RBSC/YIS805_VideoBoard/Pics/tested.jpg

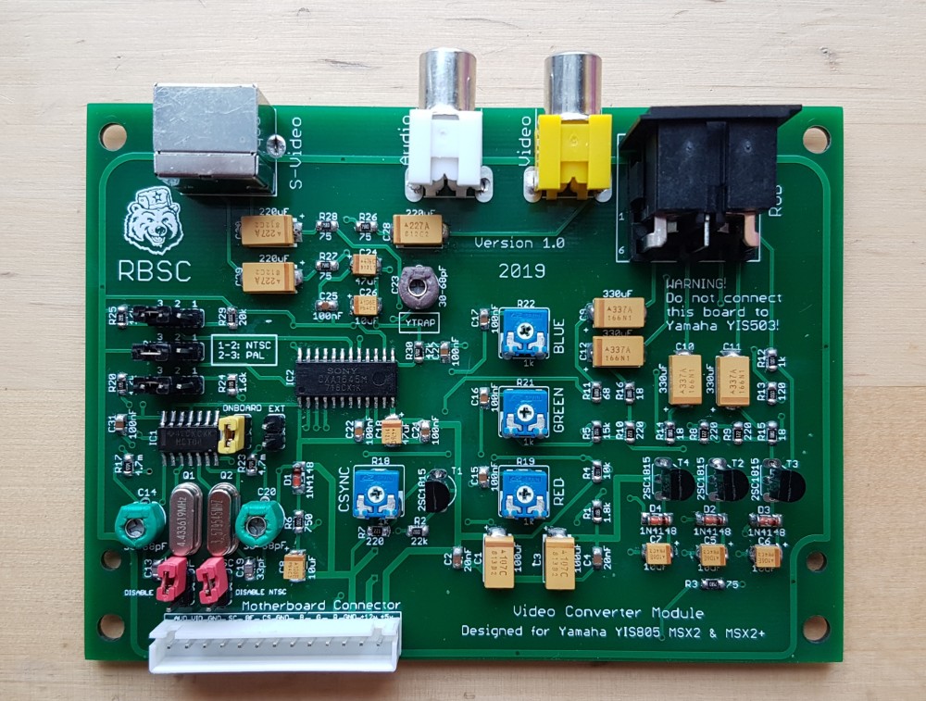
Pics/tested.jpg
