RBSC/YIS805_VideoBoard/Pics/videoboardback.jpg

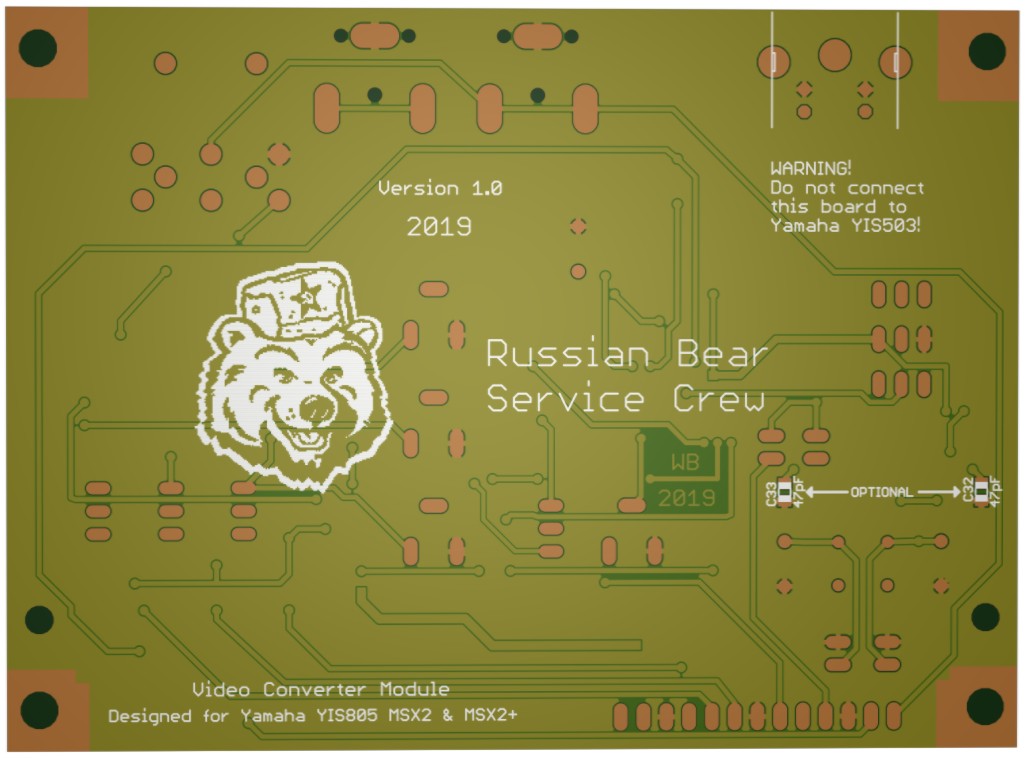
Pics/videoboardback.jpg
