RBSC/YIS805_VideoBoard/Doc/schematics.png

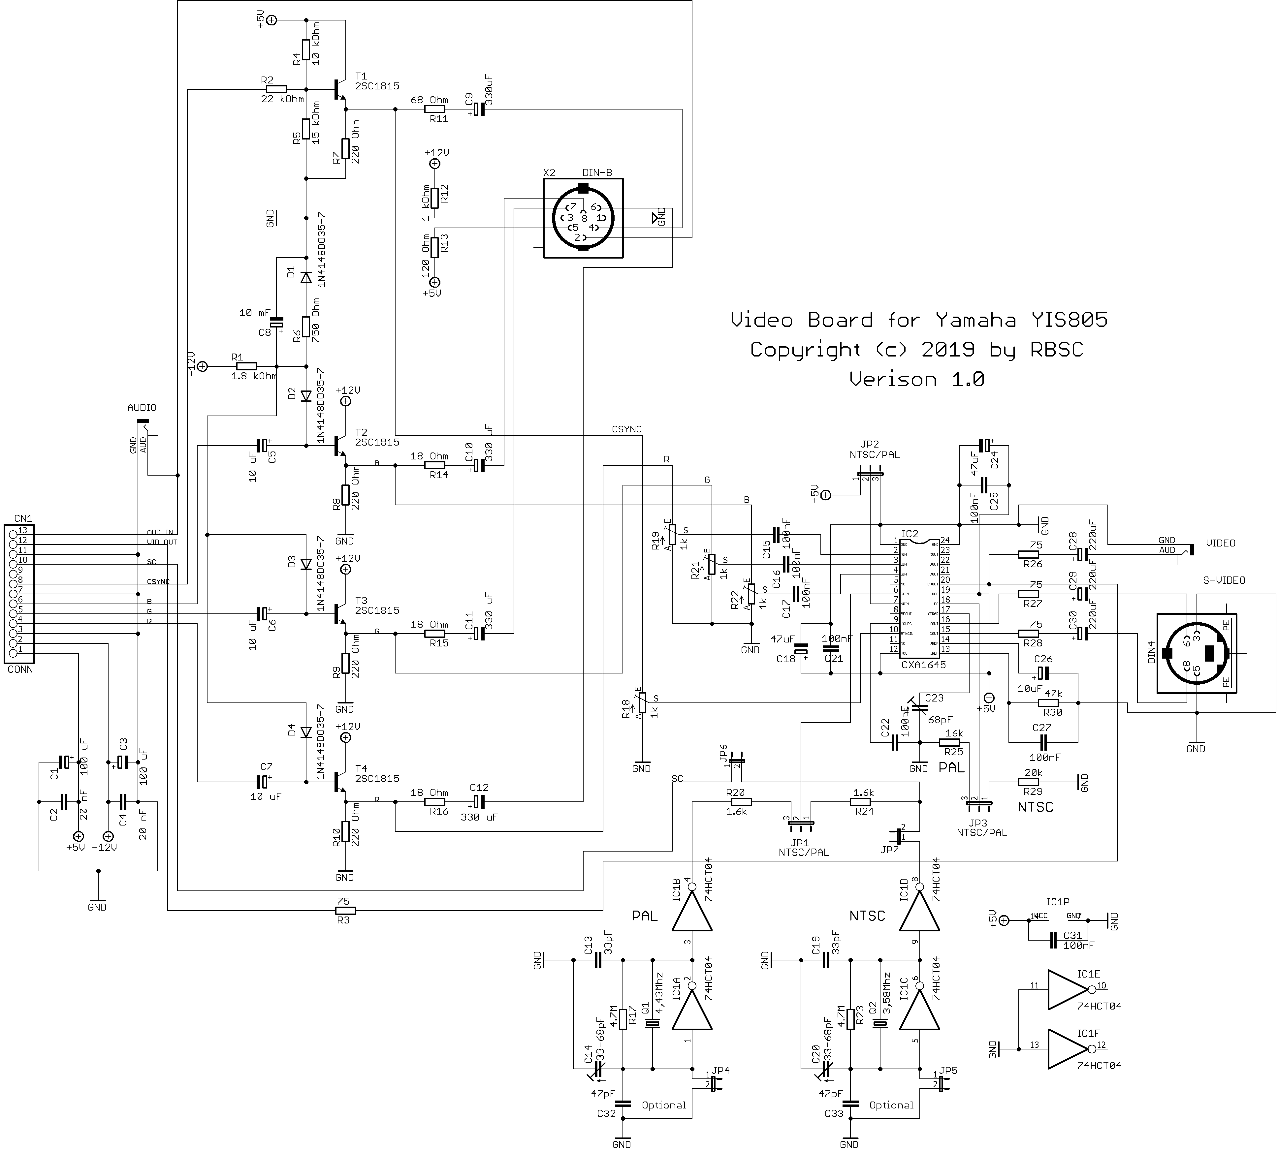
Doc/schematics.png
