RBSC/YIS805_VideoBoard/Pics/videoboard.jpg

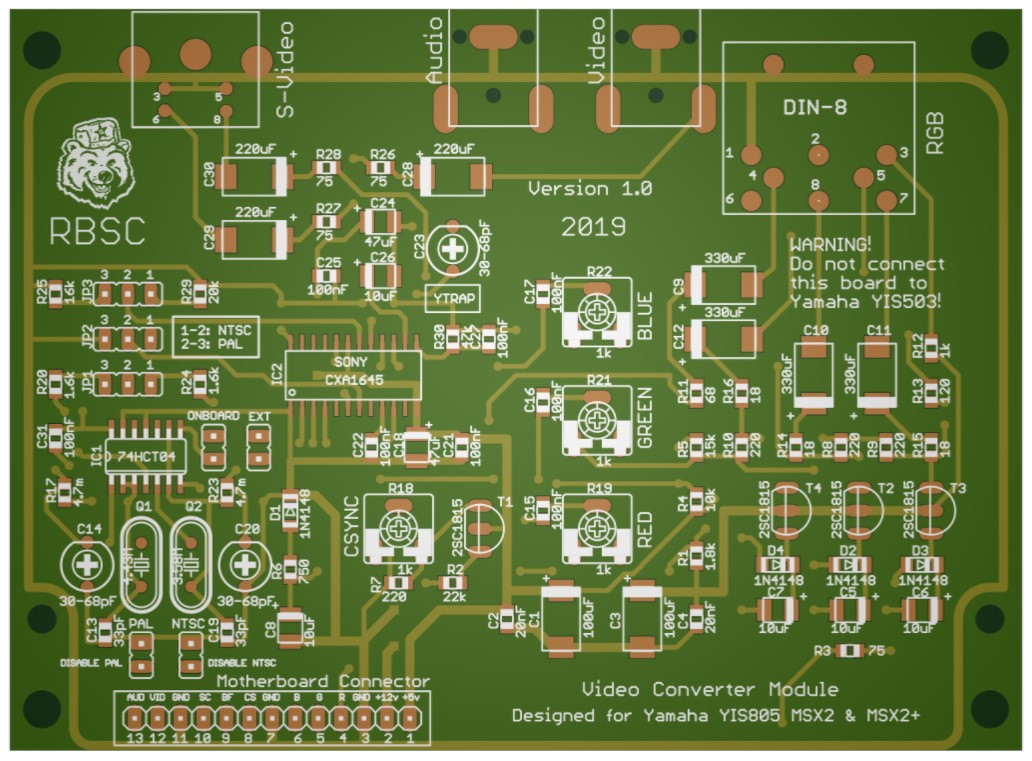
Pics/videoboard.jpg
