RBSC/YIS805_VideoBoard/Pics/videoboard_final.jpg

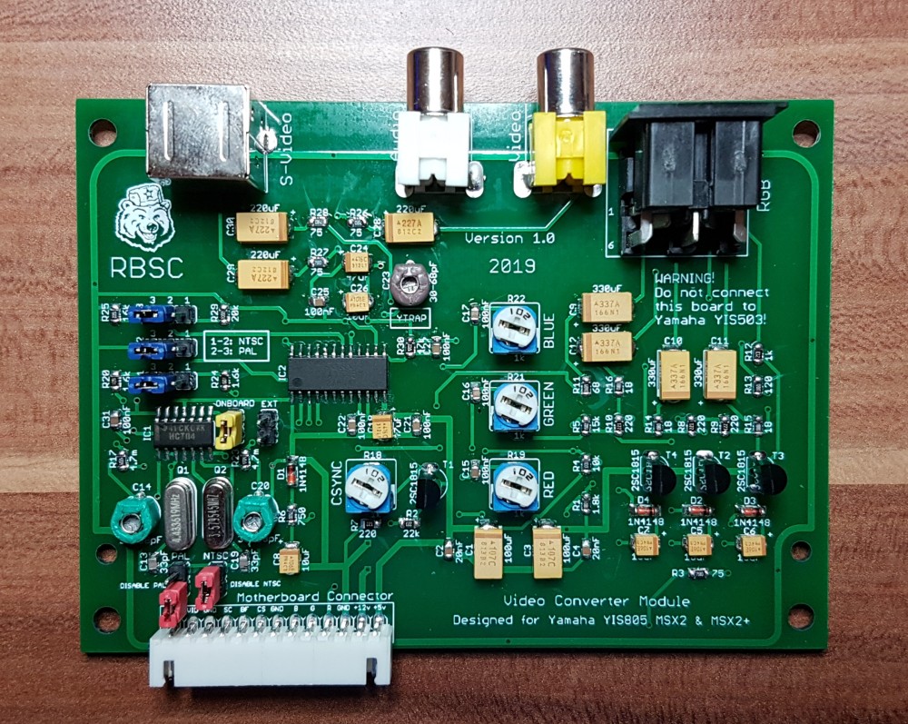
Pics/videoboard_final.jpg
