RBSC/YIS805_VideoBoard/Board/video_board_yis805.brd

## EAGLE design Board/video_board_yis805.brd (2019-12-11)

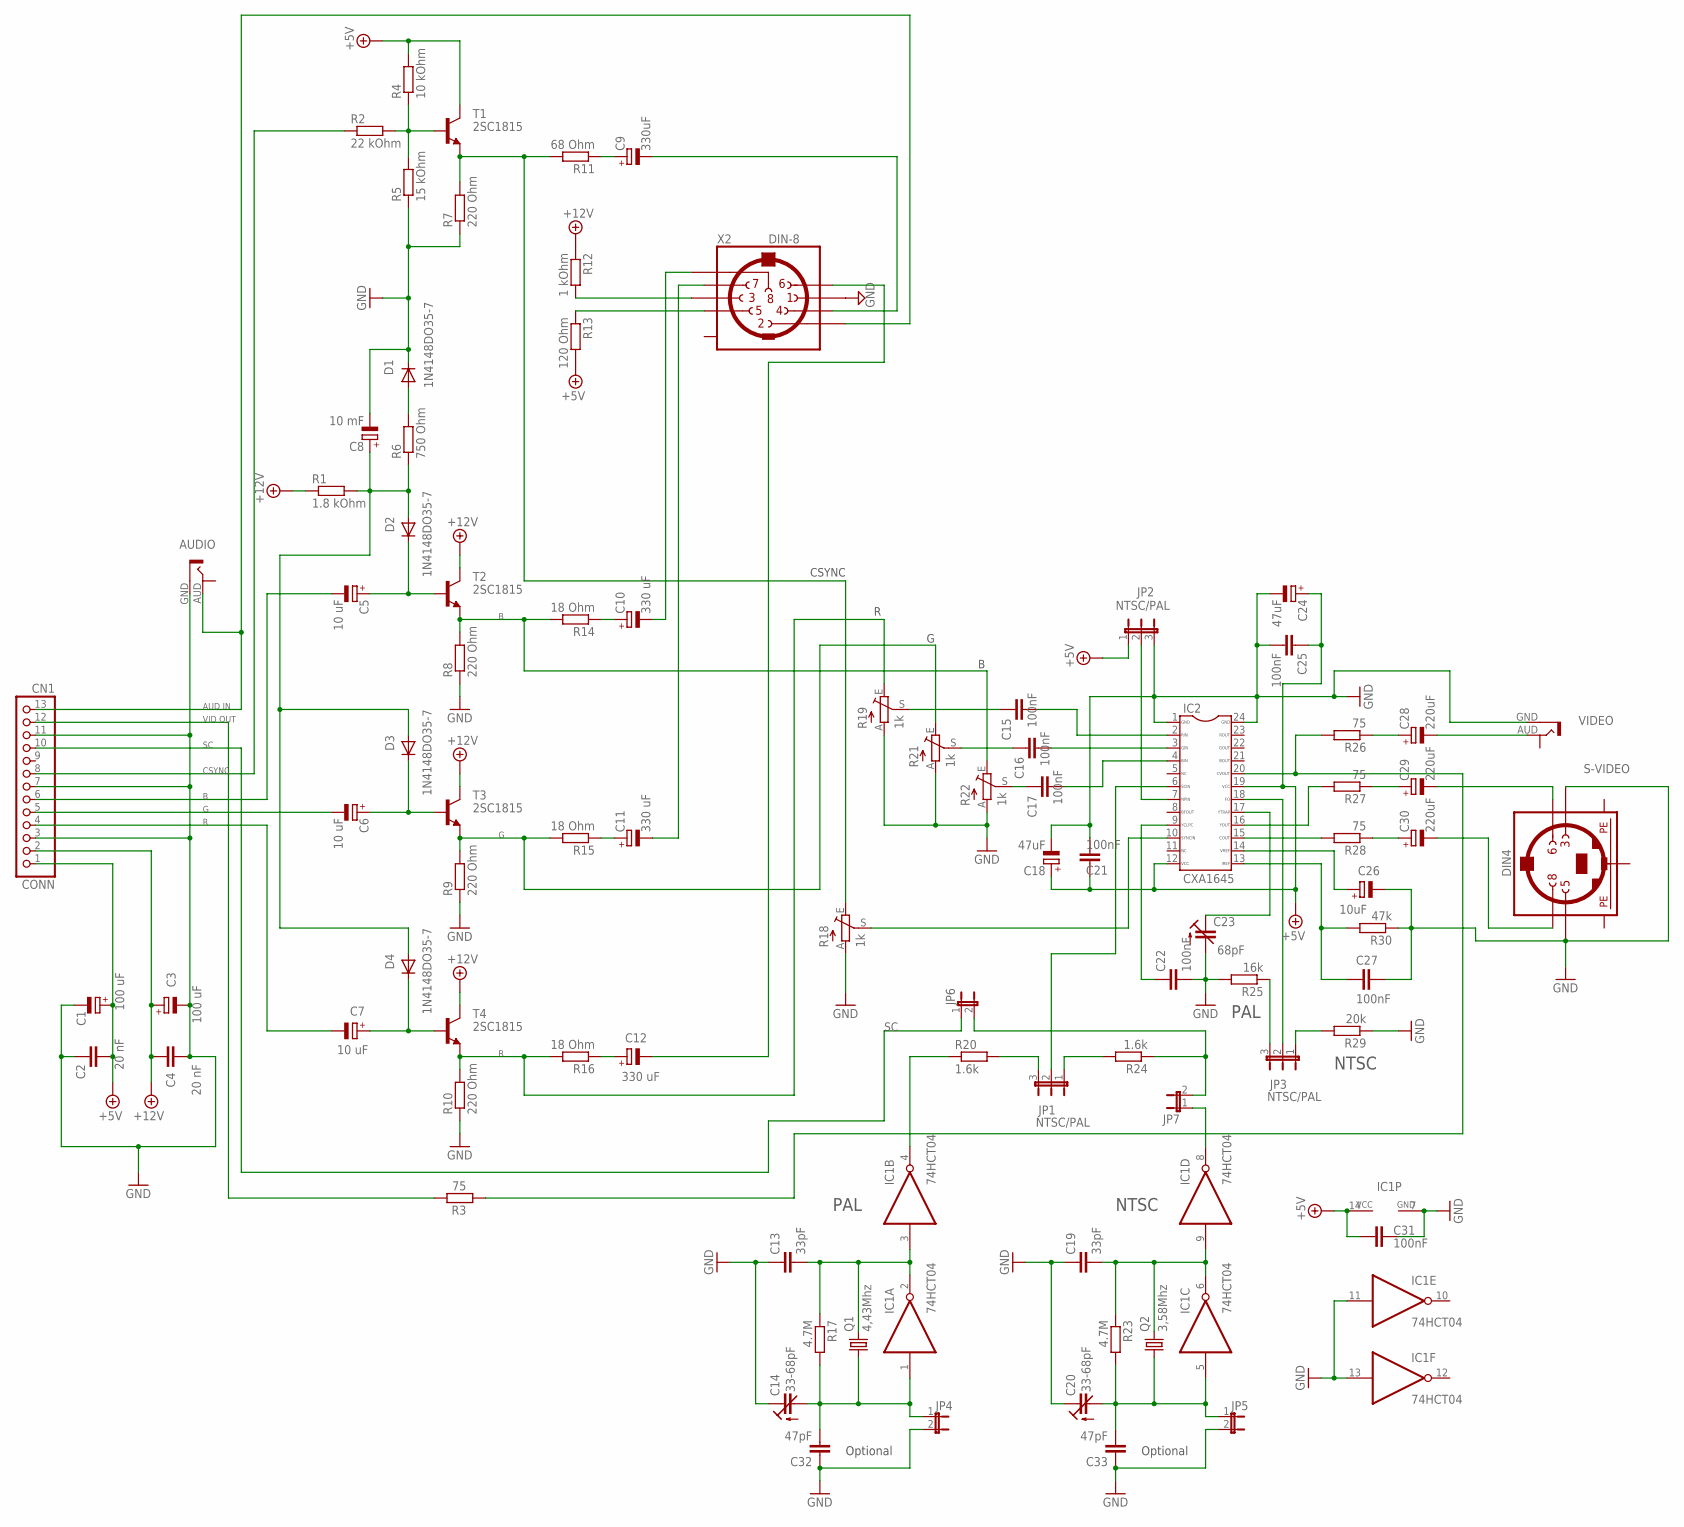
[picture p6: schematic video_board_yis805.sch]

Parts:
AUDIO: RCA
C1, C3: 100 uF; SMC_D
C2, C4: 20 nF; C0805
C5, C6, C7: 10 uF; SMC_B
C8: 10 mF; SMC_B
C9: 330uF; SMC_D
C10, C11, C12: 330 uF; SMC_D
C13, C19: 33pF; C0805
C14, C20: 33-68pF; CTRIMTZ03
C15, C16, C17, C21, C22, C25, C27, C31: 100nF; C0805
C18, C24: 47uF; SMC_B
C23: 68pF; CTRIMTZ03
C26: 10uF; SMC_B
C28, C29, C30: 220uF; SMC_D
C32, C33: 47pF; C0805
CONN: CN1; 1X13
D1, D2, D3, D4: 1N4148DO35-7; MINIMELF
IC1: 74HCT04; SO14
IC2: CXA1645; SOP24
JP1, JP2, JP3: NTSC/PAL; JP2
JP4, JP5, JP6, JP7: JP1E; JP1
Q1: 4,43Mhz; HC49/S; MPN HC49SM-3.6864-30-50-60-16-ATF
Q2: 3,58Mhz; HC49/S; MPN HC49SM-3.6864-30-50-60-16-ATF
R1: 1.8 kOhm; R0805
R2: 22 kOhm; R0805
R3, R26, R27, R28: 75; R0805
R4: 10 kOhm; R0805
R5: 15 kOhm; R0805
R6: 750 Ohm; R0805
R7, R8, R9, R10: 220 Ohm; R0805
R11: 68 Ohm; R0805
R12: 1 kOhm; R0805
R13: 120 Ohm; R0805
R14, R15, R16: 18 Ohm; R0805
R17, R23: 4.7M; R0805
R18, R19, R21, R22: 1k; CA6V
R20, R24: 1.6k; R0805
R25: 16k; R0805
R29: 20k; R0805
R30: 47k; R0805
S-VIDEO: DIN4; M_DIN4
T1, T2, T3, T4: 2SC1815; TO92-ECB
VIDEO: RCA
X2: DIN-8; DIN8

Connections:
+5V: C1.+, C2.1, C18.+, C21.1, C24.+, C25.1, C31.2, CONN.1, IC1.14 (VCC), IC2.12, IC2.19, JP2.1, R4.2, R13.2, T1.C
+12V: C3.+, C4.1, CONN.2, R1.1, R12.1, T2.C, T3.C, T4.C
GND: AUDIO.GND (GND1), C1.-, C2.2, C3.-, C4.2, C8.-, C13.1, C14.1 (E), C18.-, C19.1, C20.1 (E), C21.2, C22.2, C23.2 (A), C24.-, C25.2, C26.-, C27.2, C31.1, C32.1, C33.1, CONN.3, CONN.7, CONN.11, D1.C, IC1.7 (GND), IC1.11 (I), IC1.13 (I), IC2.1, IC2.24, JP2.3, JP4.2, JP5.2, R5.1, R7.1, R8.1, R9.1, R10.1, R18.A, R19.A, R21.A, R22.A, R25.2, R29.1, R30.1, S-VIDEO.3, S-VIDEO.5, VIDEO.GND (GND1), X2.1
unnamed: R10.2, R16.2, R19.E, T4.E
unnamed: C20.2 (A), C33.2, IC1.5 (I), JP5.1, Q2.1, R23.2
unnamed: JP6.2, JP7.2, R24.1
unnamed: CONN.8, R2.1
unnamed: R8.2, R14.2, R22.E, T2.E
unnamed: C15.1, R19.S
unnamed: C16.1, R21.S
unnamed: IC1.4 (O), R20.1
unnamed: JP1.1, R24.2
unnamed: C19.2, IC1.6 (O), IC1.9 (I), Q2.2, R23.1
unnamed: JP1.3, R20.2
unnamed: C8.+, D2.A, D3.A, D4.A, R1.2, R6.1
unnamed: JP3.3, R25.1
unnamed: IC2.7, JP2.2
unnamed: JP3.1, R29.2
unnamed: IC2.16, R27.2
unnamed: IC1.8 (O), JP7.1
unnamed: CONN.12, R3.2
unnamed: C23.1 (E), IC2.17
unnamed: C12.-, X2.6
unnamed: C11.-, X2.7
unnamed: C6.+, D3.C, T3.B
unnamed: C10.-, X2.8
unnamed: D1.A, R6.2
unnamed: C6.-, CONN.5
unnamed: C5.-, CONN.6
unnamed: AUDIO.AUD, CONN.13, X2.2
unnamed: C12.+, R16.1
unnamed: R12.2, X2.3
unnamed: R9.2, R15.2, R21.E, T3.E
unnamed: R13.1, X2.5
unnamed: C7.+, D4.C, T4.B
unnamed: C7.-, CONN.4
unnamed: C5.+, D2.C, T2.B
unnamed: R2.2, R4.1, R5.2, T1.B
unnamed: R7.2, R11.2, R18.E, T1.E
unnamed: C11.+, R15.1
unnamed: C10.+, R14.1
unnamed: C9.+, R11.1
unnamed: C9.-, X2.4
unnamed: C17.1, R22.S
unnamed: C16.2, IC2.3
unnamed: C15.2, IC2.2
unnamed: C17.2, IC2.4
unnamed: C14.2 (A), C32.2, IC1.1 (I), JP4.1, Q1.1, R17.2
unnamed: C13.2, IC1.2 (O), IC1.3 (I), Q1.2, R17.1
unnamed: IC2.10, R18.S
unnamed: IC2.6, JP1.2
unnamed: IC2.20, R3.1, R26.2
unnamed: C22.1, IC2.9
unnamed: IC2.18, JP3.2
unnamed: IC2.15, R28.2
unnamed: C28.+, R26.1
unnamed: C29.+, R27.1
unnamed: C30.+, R28.1
unnamed: C26.+, IC2.14
unnamed: C27.1, IC2.13, R30.2
unnamed: C28.-, VIDEO.AUD
unnamed: C29.-, S-VIDEO.6
unnamed: C30.-, S-VIDEO.8
PE1: S-VIDEO.SH1 (PE1)
PE2: S-VIDEO.SH2 (PE2)
PE3: S-VIDEO.SH3 (PE3)
SC: CONN.10, JP6.1

Notes on the sheet:
CSYNC
AUD IN
VID OUT
PAL
NTSC
Optional

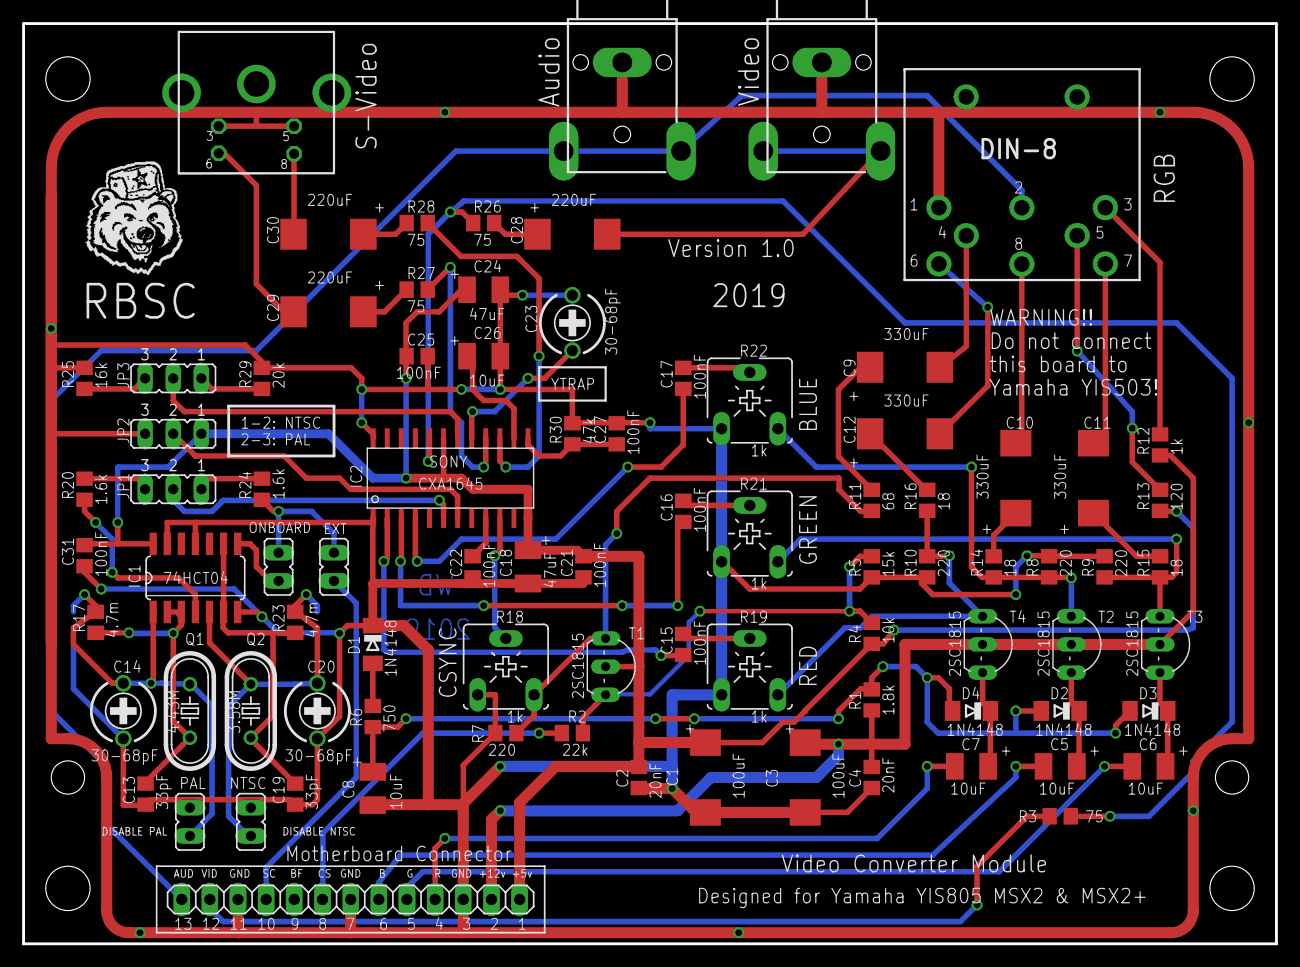
[picture p7: board video_board_yis805.brd from above]

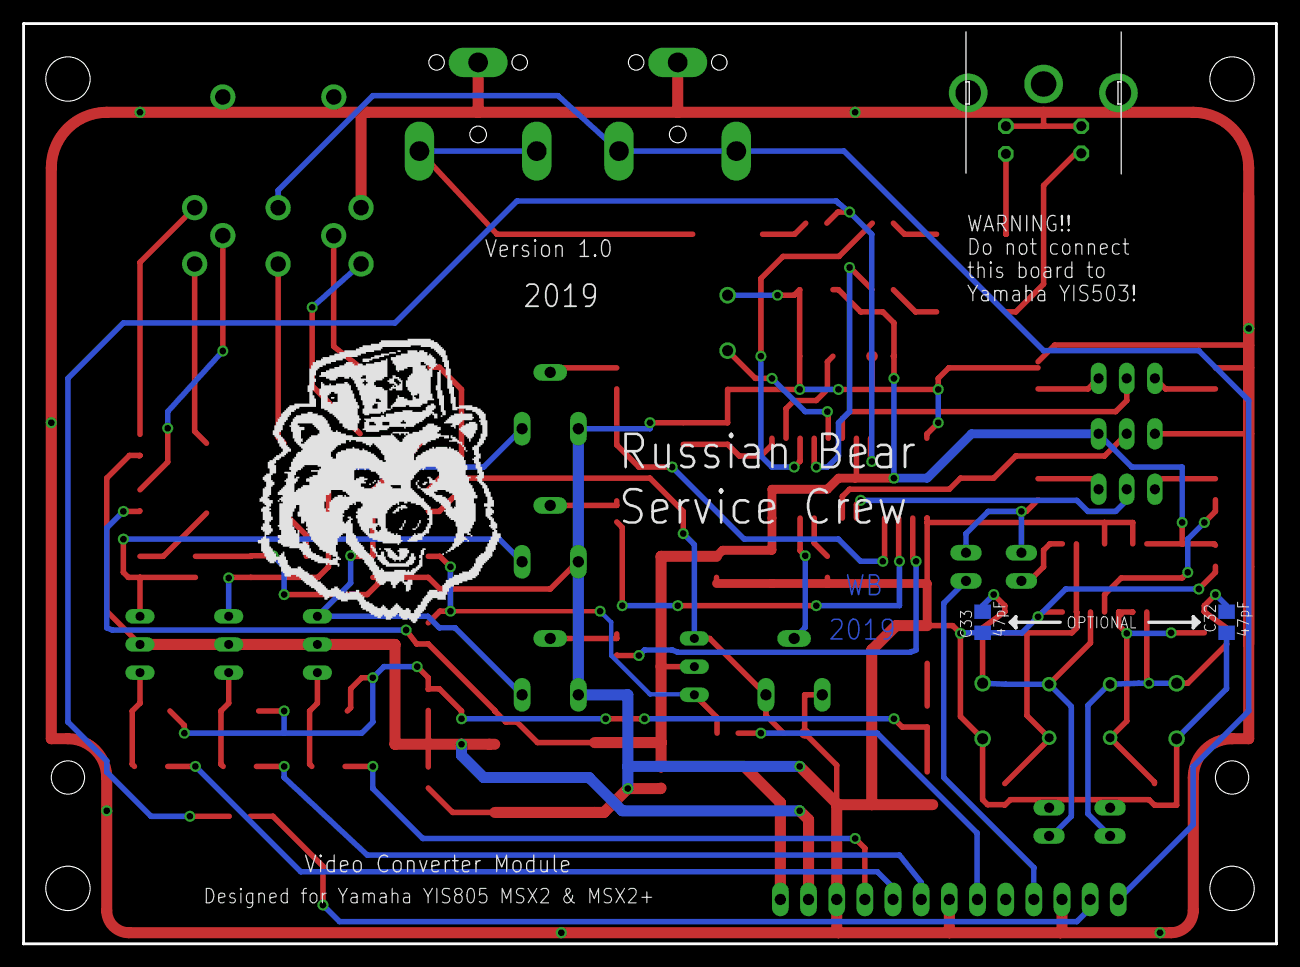
[picture p8: board video_board_yis805.brd from below]

Board: 2 copper layers, 113.0 x 83.0 mm, 87 parts (2 on the bottom side), 64 nets.
