RBSC/YIS805_VideoBoard/(commit log)

2019-12-11 Initial release 12.12.2019
    Initial release of the project's sources and docs
    [video_board_yis805.brd, video_board_yis805.sch]
2019-12-21 Updated 21.12.2019
    Updated picture of the assembled board
