RBSC/YIS805_VideoBoard/(notices)

Notices in the files:
Board/video_board_yis805.sch:
Copyright (c) 2019 by RBSC
